jeffreydthompson/Open_Roadster/(commit log)

2026-11-11 Add app icon and name, lock to one landscape orientation
    - App icon and the home screen name "Roadster Remote"
    - Entertainment app category
    - Landscape right only, so the tilt steering always reads the same way
    - Drop shadows on the controls, and remove the old commented-out layout
    - Tidy CentralControl: group state and UI controls, and keep the
    throttle scaling next to the throttle
2026-11-11 Add clangd editor setup for the firmware
    Add an lsp command to esp-flash.sh that generates compile_commands.json,
    a .clangd config for the ESP32 toolchain, per-OS setup notes in the
    README, and forward declarations for the low-battery functions.
